andreagallo-dev/twin-lamps/3d-models/base_v4_1.stl

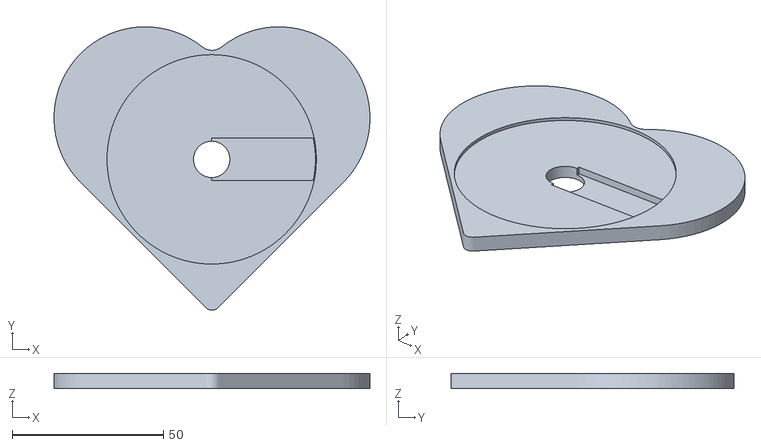
[picture p9: CAD file, 2026-10-25]
3d-models/base_v4_1.stl
104.5 x 93.7 x 5.00
