andreagallo-dev/twin-lamps/3d-models/tube_v4.stl

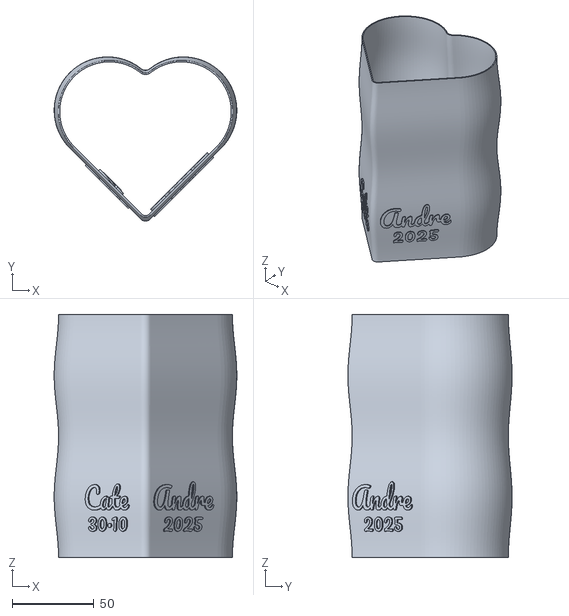
[picture p10: CAD file, 2026-10-25]
3d-models/tube_v4.stl
112.0 x 100.6 x 149.0
