andreagallo-dev/twin-lamps/3d-models/cap_v4.stl

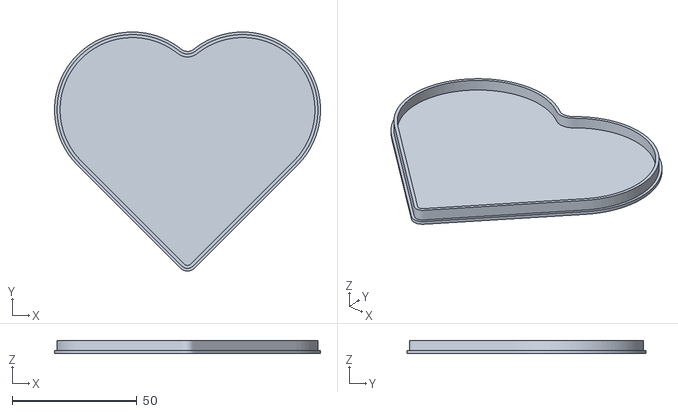
[picture p11: CAD file, 2026-10-25]
3d-models/cap_v4.stl
106.7 x 95.9 x 5.20
